GSNT/TFT-Stuff/Hardware/TFT-Watterott/LPCXpresso2-1.jpg

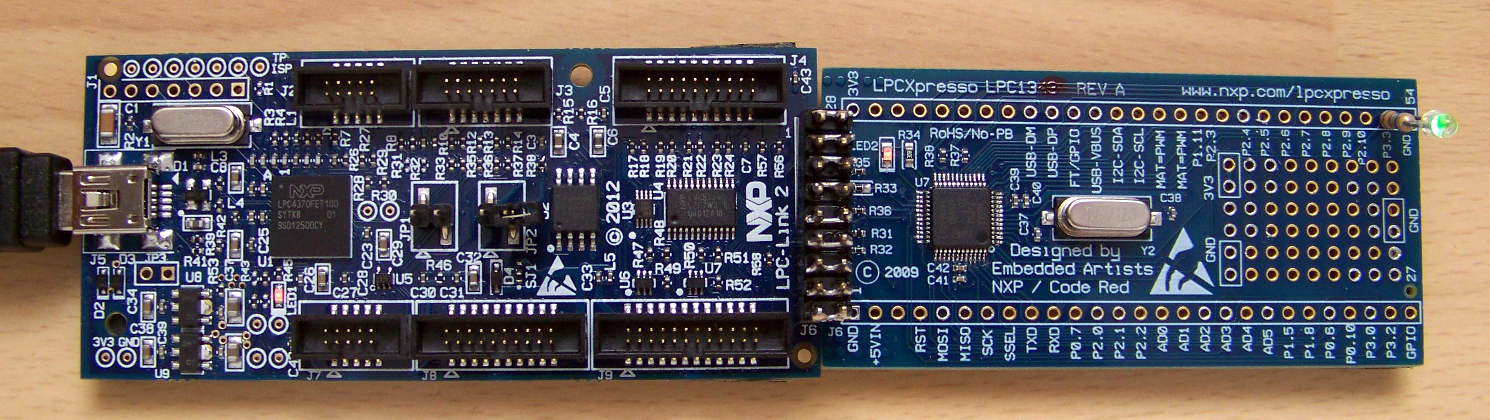
Hardware/TFT-Watterott/LPCXpresso2-1.jpg
