GSNT/TFT-Stuff/Hardware/TFT-Watterott/V2.1LPC1317.jpg

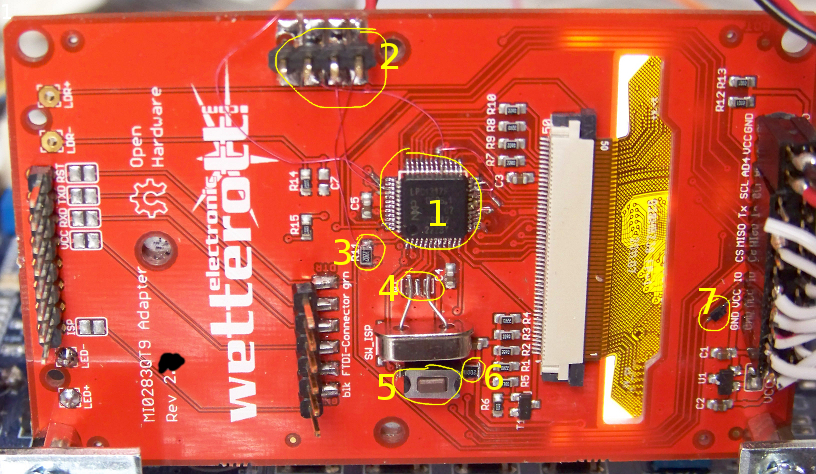
Hardware/TFT-Watterott/V2.1LPC1317.jpg
