GSNT/TFT-Stuff/Hardware/TFT-Watterott/Hardware V3.txt

Hardware V3.0
-------------
23.06.2013: Start mit V2 Hardware

->SWD-Connector
	-added:   Mini-SWD Connector, 4-pol 2.54 SMD
	-changed: Pin 29 an SWD-CON
	-changed: PAD 29 an Pin 22 (P0.6 SCK0)
	-changed: Pin 39 an SWD-CON
	-changed: PAD 39 an Pin 30 (AD6)
