GSNT/TFT-Stuff/Hardware/TFT-Watterott/LPCXpresso2-2.jpg

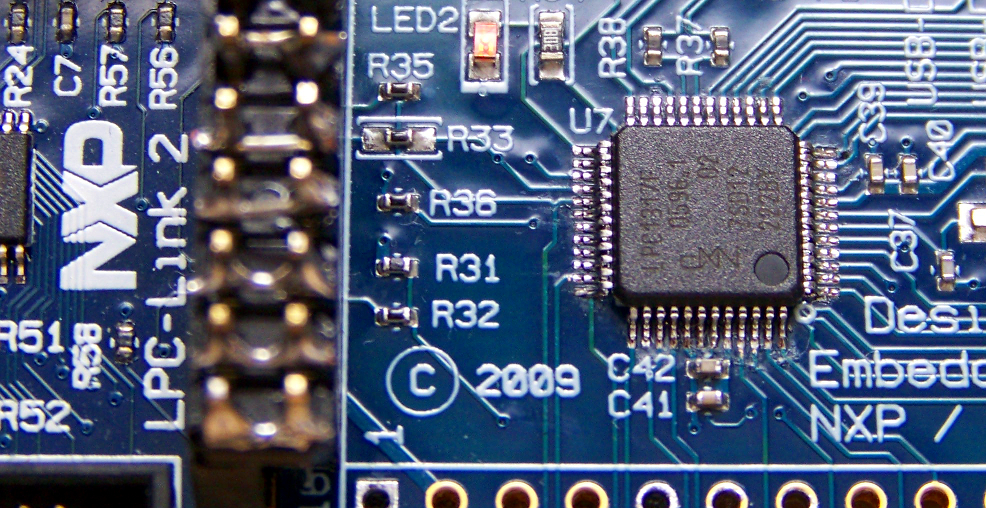
Hardware/TFT-Watterott/LPCXpresso2-2.jpg
