GSNT/TFT-Stuff/Hardware/TFT-Watterott/MI0283QT_v2G1.jpg

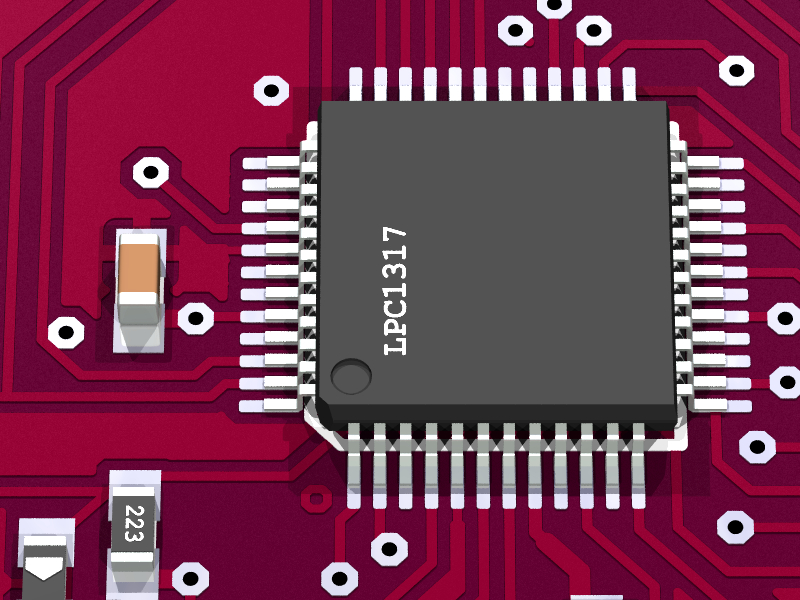
Hardware/TFT-Watterott/MI0283QT_v2G1.jpg
