GSNT/TFT-Stuff/Hardware/TFT-Watterott/MI0283QT_v20.bmp

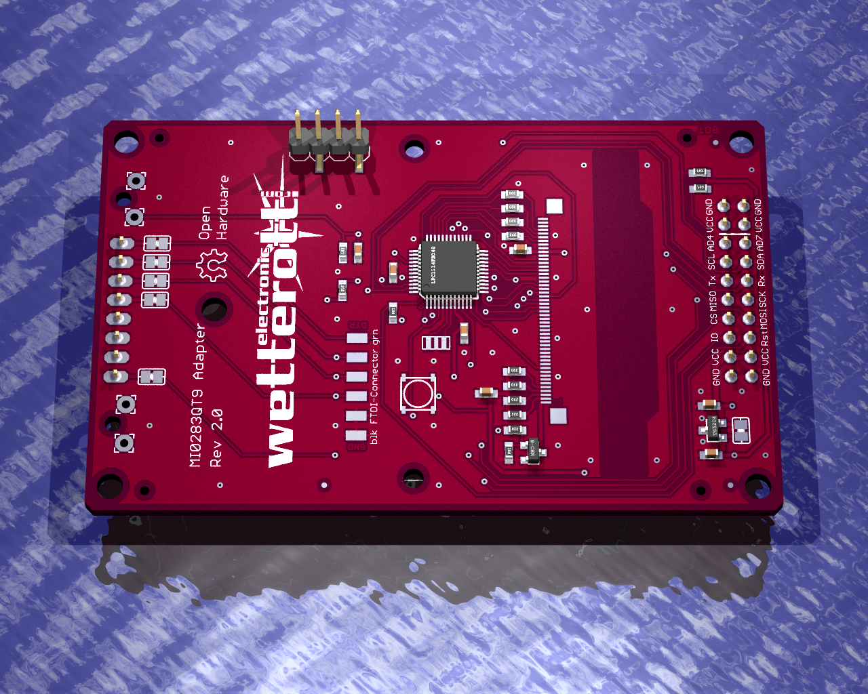
Hardware/TFT-Watterott/MI0283QT_v20.bmp
