GSNT/TFT-Stuff/Hardware/TFT-Watterott/Reset_ISP.jpg

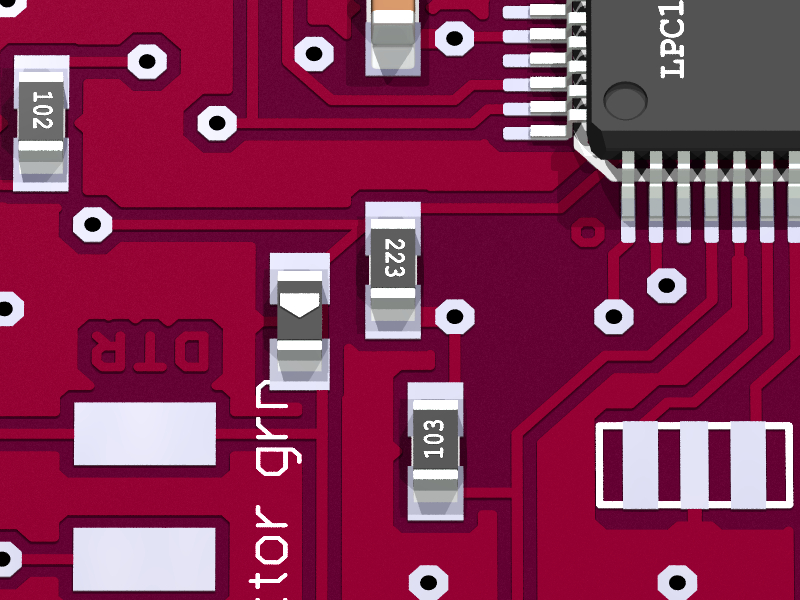
Hardware/TFT-Watterott/Reset_ISP.jpg
