GSNT/TFT-Stuff/Hardware/TFT-Watterott/V2.1LPC1317_2.jpg

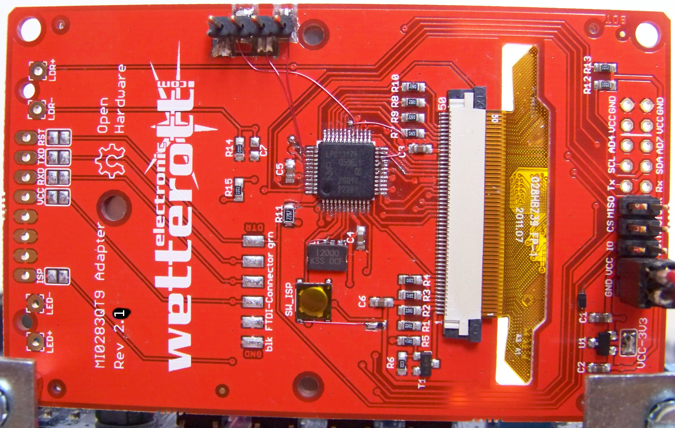
Hardware/TFT-Watterott/V2.1LPC1317_2.jpg
