GSNT/TFT-Stuff/(commit log)

2013-06-23 Add Hardware
    [MI0283QT_v20.brd, MI0283QT_v20.sch]
2013-07-06 New Board
